hysamah/ES_project2/(commit log)

2021-04-27 IMU first test
2021-04-29 Test IMU pitch roll
2021-05-04 updated flex sensor values
    [glove_driver.c]
2021-05-27 pid no communication (future work start)
2021-05-27 Added PID testing video
2021-05-27 Update the PID controller comments.
